ultrazohm/uz_d_voltage_3v3_5v/doc/Level_Shifter_Output_Enable_Concept.png

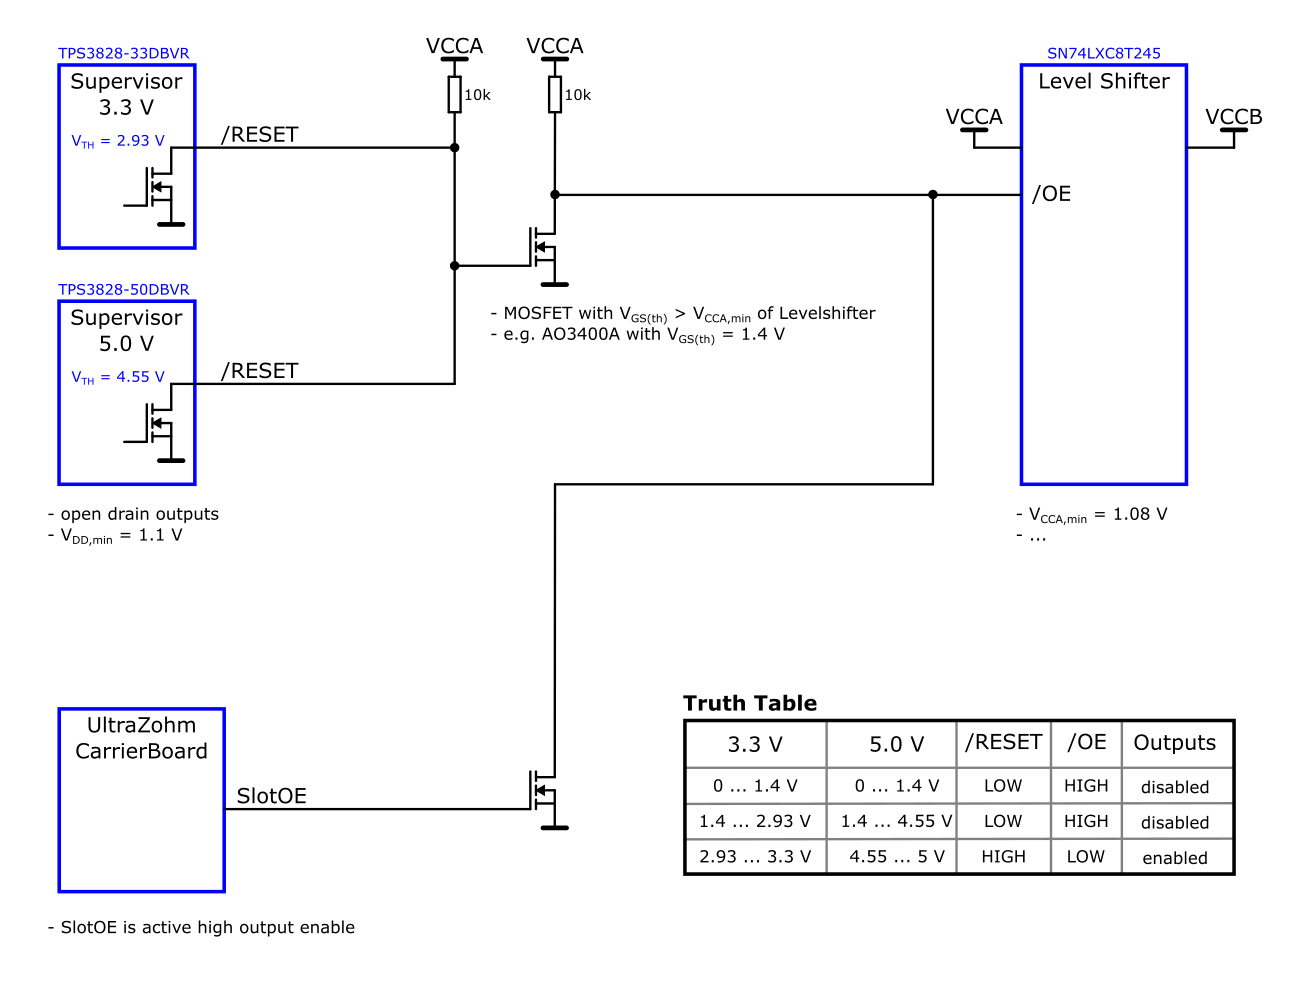
doc/Level_Shifter_Output_Enable_Concept.png
