ultrazohm/uz_d_voltage_3v3_5v/Project Outputs for UZ_D_Voltage_3V3_5V/Rev03/BOM/BOM_JLC-UZ_D_Voltage_3V3_5V(Default).xlsx

Quantity | Comment | Designator | Manufacturer | Value | Description | Footprint | Voltage | Dielectric | Manufacturer Part Number | LCSC Part Number
12 | 100 nF | C1, C2, C3, C4, C5, C6, C7, C8, C9, C10, C11, C12 | UZgen | 100 nF | Generic capacitor | C_0603_TE | 50V |  | UZgen_C_0603_100nF_50V_X7R
2 | 1 µF | C13, C15 | UZgen | 1 µF | Generic capacitor | C_0603_TE | 16V |  | UZgen_C_0603_1uF_16V_X7R
1 | 220 nF | C14 | UZgen | 220 nF | Generic capacitor | C_0603_TE | 50V |  | UZgen_C_0603_220nF_50V_X7R
1 | 150060BS84000 | D1 | Wuerth Elektronik |  | WL-SMCW SMD Mono-color Chip LED Waterclear Blue | WL-SMCW_0603 |  |  | 150060BS84000 | C5197644
1 | LED RGB | D2 | Amicc | LED RGB | RGB LED - SMD 1615 | LED_1615 |  |  | A-SP1943B1GHR6C-C01-2T | C19171342
3 | Littelfuse_PTC_1812 | F1, F2, F3 | Littelfuse | PTC, 1.1 A, 24V | POLYSWITCH RESETTABLE DEVICES | 1812_PTC_Polyfuse_Littelfuse | 24V |  | Littelfuse_PTC_1812 | C70119
1 | LPF-C011304S | LG1 | Lumex | LPF-C011304S | LED Light Pipes RA Light Pipe Clr 2.8mm Round | LPF-C011304S |  |  | LPF-C011304S
2 | BSS138LT3G | Q1, Q2 | ON Semicondutor | 50 V | Power MOSFET, n-Channel, 200 mA, 50 V | SOT-23-3 |  |  | BSS138LT3G | C83790
71 | 10k | R2, R39, R40, R41, R42, R43, R44, R45, R46, R47, R48, R49, R50, R51, R52, R53, R54, R55, R56, R57, R58, R59, R60, R61, R62, R63, R64, R65, R66, R67, R68, R69, R70, R71, R72, R73, R74, R75, R78, R79, R85, R86, R87, R88, R89, R90, R91, R92, R93, R94, R95, R96, R97, R98, R99, R100, R101, R102, R103, R104, R105, R106, R107, R108, R109, R110, R111, R112, R113, R114, R115 | UZgen | 10k | Generic resistor | R_0603_TE |  |  | UZgen_R_0603_10k
3 | 4k7 | R3, R4, R5 | UZgen | 4k7 | Generic resistor | R_0603_TE |  |  | UZgen_R_0603_4k7
2 | 100k | R6, R7 | UZgen | 100k | Generic resistor | R_0603_TE |  |  | UZgen_R_0603_100k
1 | 24k9 | R8 | Vishay | 24k9 | SMD resistor 1% | RES 0603_1608 |  |  | CRCW060324K9FKEA | C844763
30 | 39R | R9, R10, R11, R12, R13, R14, R15, R16, R17, R18, R19, R20, R21, R22, R23, R24, R25, R26, R27, R28, R29, R30, R31, R32, R33, R34, R35, R36, R37, R38 | UZgen | 39R | Generic resistor | R_0603_TE |  |  | UZgen_R_0603_39R
2 | 0R | R76, R77 | UZgen | 0R | Generic resistor | R_0603_TE |  |  | UZgen_R_0603_0R
1 | 2k7 | R80 | UZgen | 2k7 | Generic resistor | R_0603_TE |  |  | UZgen_R_0603_2k7
1 | 1k | R81 | UZgen | 1k | Generic resistor | R_0603_TE |  |  | UZgen_R_0603_1k
2 | 300R | R82, R83 | UZgen | 300R | Generic resistor | R_0603_TE |  |  | UZgen_R_0603_300R
1 | 47R | R84 | UZgen | 47R | Generic resistor | R_0603_TE |  |  | UZgen_R_0603_47R
1 | SS-3235S-L1 | S1 | XKB Connection | DPDT | 50mA Horizontal attachment DPDT 12V 12V 50mA 10,000 times Black SMD Slide Switches ROHS | SS-3235S-L1 |  |  | SS-3235S-L1 | C500055
1 | CAS-120B1 | S2 | Nidec Components | SPDT | Slide Switches SPDT, ON-ON, slide, gull wing SMD terminals, 100mA @ 6V DC, bulk packaging, non-washable without seal tape | CAS120B1 |  |  | CAS-120B1 | C3664598
1 | DSHP04TS-S | SW1 | XKB Connectivity | DIP-Switch | 04p, 1.27mm Pitch, Horizontal, HP Type, SMT, flat Actuator, black, with Tape, T&R | 416131160804 |  |  | DSHP04TS-S | C319050
9 | 5015 | TP3, TP4, TP7, TP8, TP9, TP10, TP11, TP12, TP13 | Keystone Electronics | SMD Testpoint | Circuit Board Hardware - PCB SM TEST POINT ON T&R - MINIATURE | FP-5015-MFG |  |  | 5015 | C5199798
1 | M24C02-WMN6TP | U1 | STMicroelectronics | M24C02-WMN6TP | 2Kbit I2C SOP-8 EEPROM ROHS | D0008A_N |  |  | M24C02-WMN6TP | C7562
4 | SN74LXC8T245PWR | U2, U3, U4, U5 | Texas Instruments | 1.1 - 5.5 V | 8-bit Dual-Supply Bus Transceiver with Configurable Level Shifting and 3-State Outputs | TSSOP-24 |  |  | SN74LXC8T245PWR | C4363995
1 | TLV840MADL29DBVR | U6 | Texas Instruments | TLV840-29 | Supervisory Circuits 2.9V Monitor | SOT23-5_DBV |  |  | TLV840MADL29DBVR | C3687807
1 | PCA9534PWR | U7 | Texas Instruments |  | 8-bit 2.3- to 5.5-V I2C/SMBus I/O expander with interrupt & config registers | TSSOP-16_PW0016A_N |  |  | PCA9534PWR | C133803
1 | TLV840NADL46DBVR | U8 | Texas Instruments | TLV840-46 | Supervisory Circuits 4.6V Monitor | SOT23-5_DBV |  |  | TLV840NADL46DBVR | C2870132
1 | IPL1-115-01-L-D-RA-K | X2 | SAMTEC |  | Terminal Assembly, Double Row, Right Angle, Thru-Hole, 2.54 mm x 2.54 mm Pitch, 30 Pins | IPL1-115-01-XX-D-RA |  |  | IPL1-115-01-L-D-RA-K
1 | IPL1-120-01-L-D-RA-K | X3 | SAMTEC |  | Terminal Assembly, Double Row, Right Angle, Thru-Hole, 2.54 mm x 2.54 mm Pitch, 40 Pins | IPL1-120-01-XX-D-RA |  |  | IPL1-120-01-L-D-RA-K
