ultrazohm/uz_d_voltage_3v3_5v/Project Outputs for UZ_D_Voltage_3V3_5V/Rev03/DOC/SCH_UZ_D_Voltage_3V3_5V_Default_Rev03.PDF

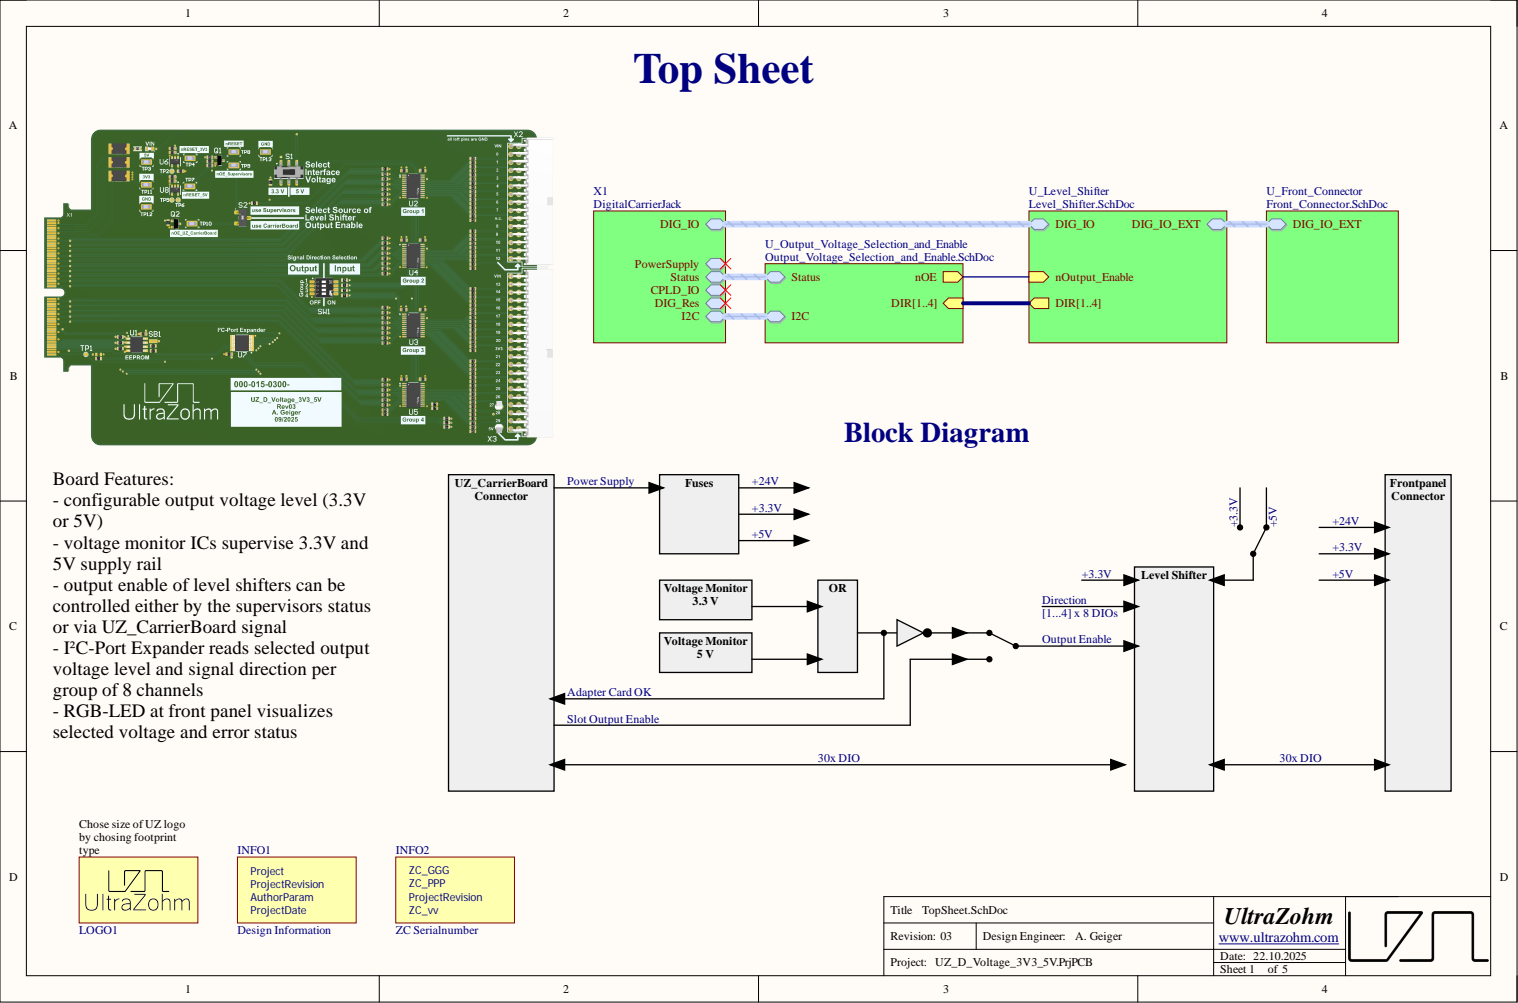
[picture p4: page 1]

Board Features:
- configurable output voltage level (3.3V
- voltage monitor ICs supervise 3.3V and
5V supply rail
- output enable of level shifters can be
controlled either by the supervisors status
or via UZ_CarrierBoard signal
- I²C-Port Expander reads selected output
voltage level and signal direction per
group of 8 channels
- RGB-LED at front panel visualizes
selected voltage and error status

Chose size of UZ logo
by chosing footprint
type

Revision:

Date: 22.10.2025

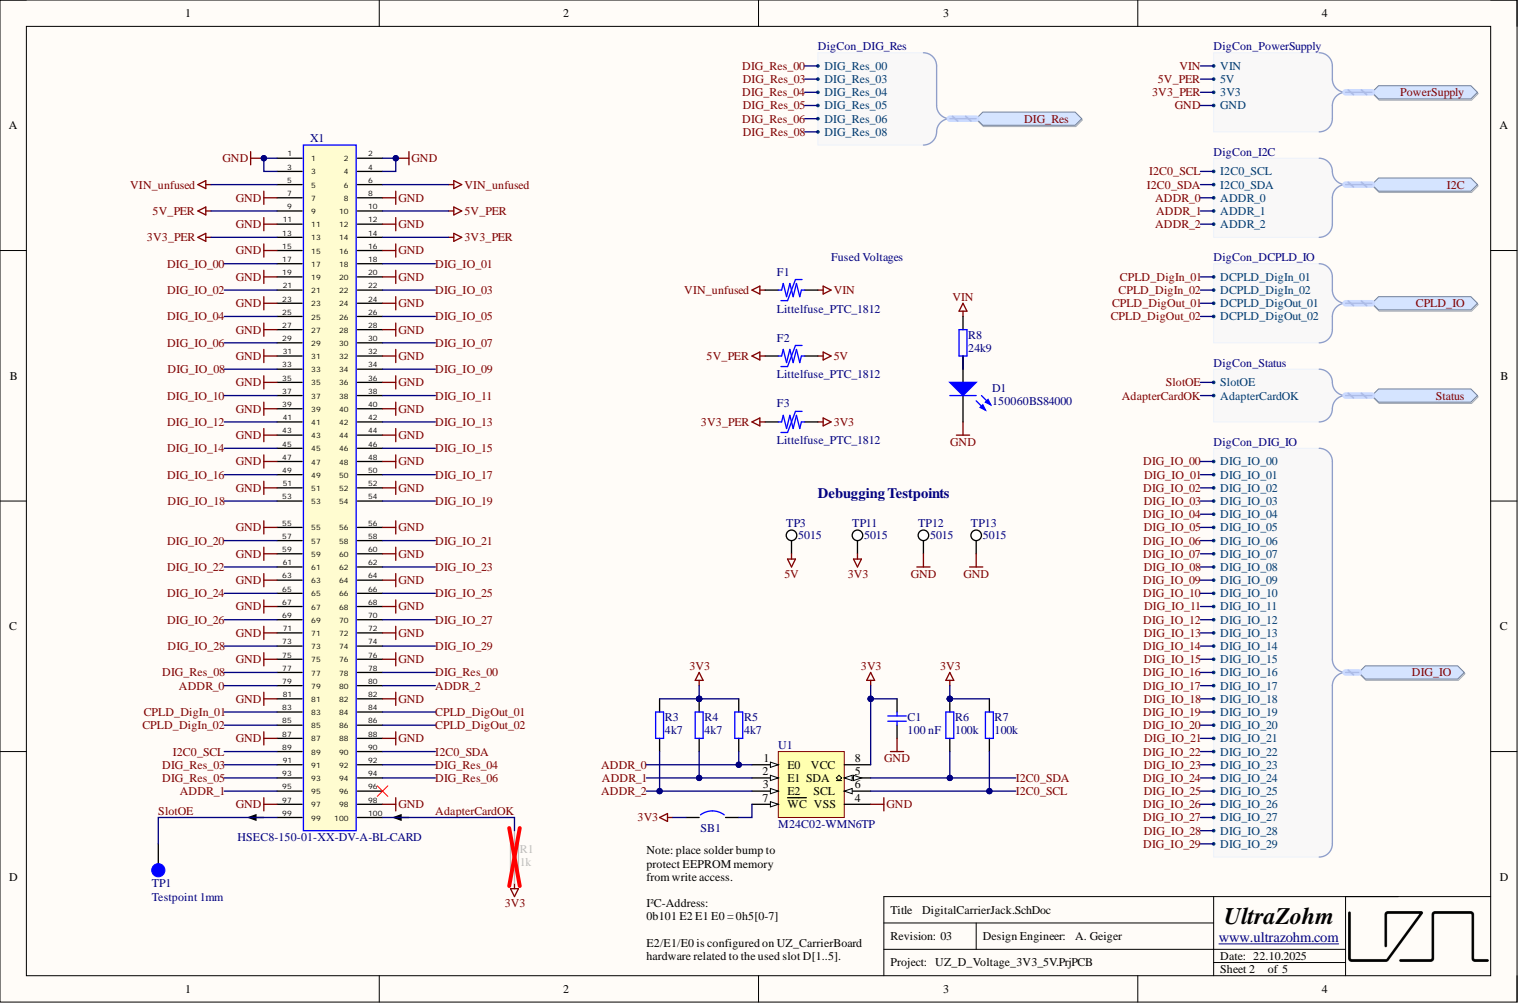
[picture p5: page 2]

Rev i s n | Des g E er A. Gei ger

Dat e :

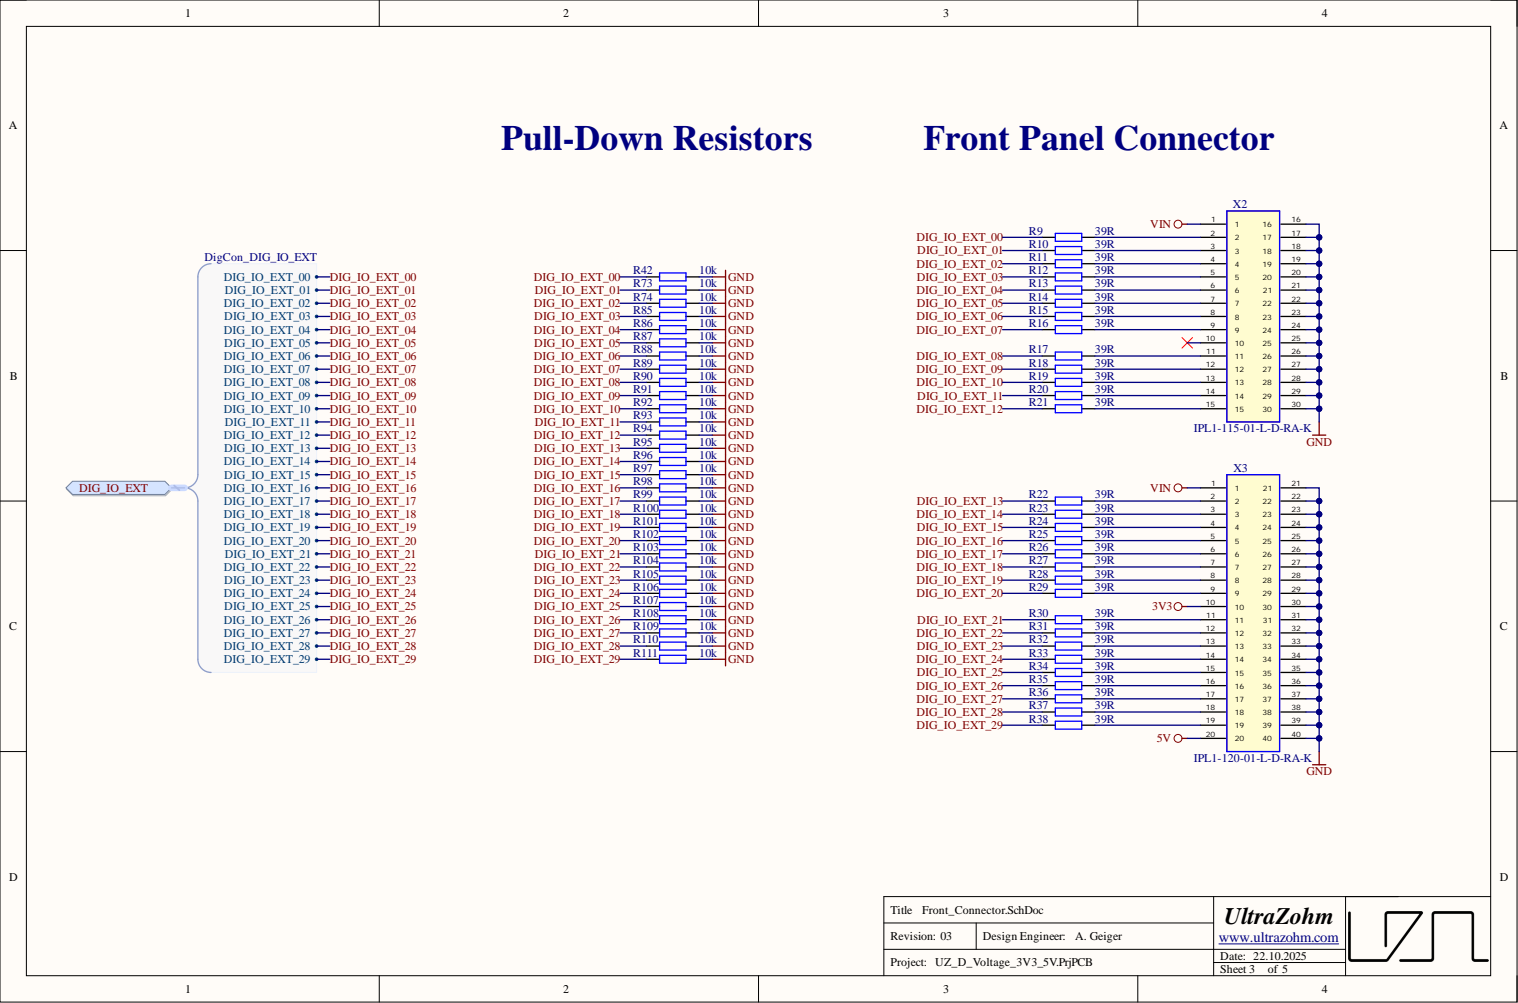
[picture p6: page 3]

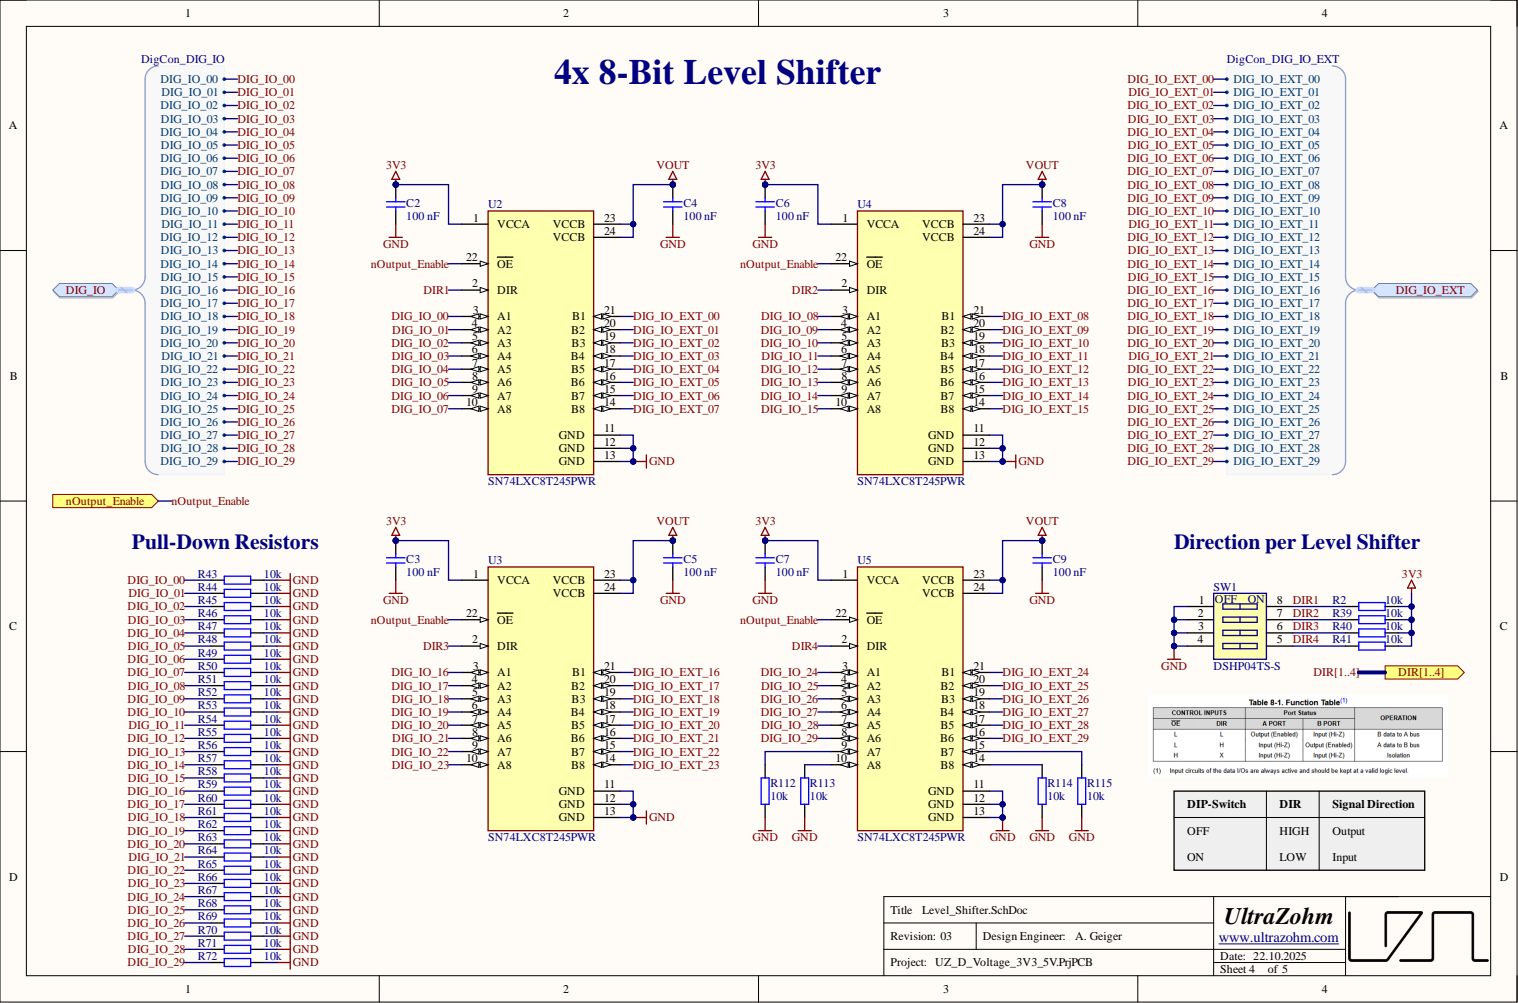
[picture p7: page 4]

Direction per Level Shifter

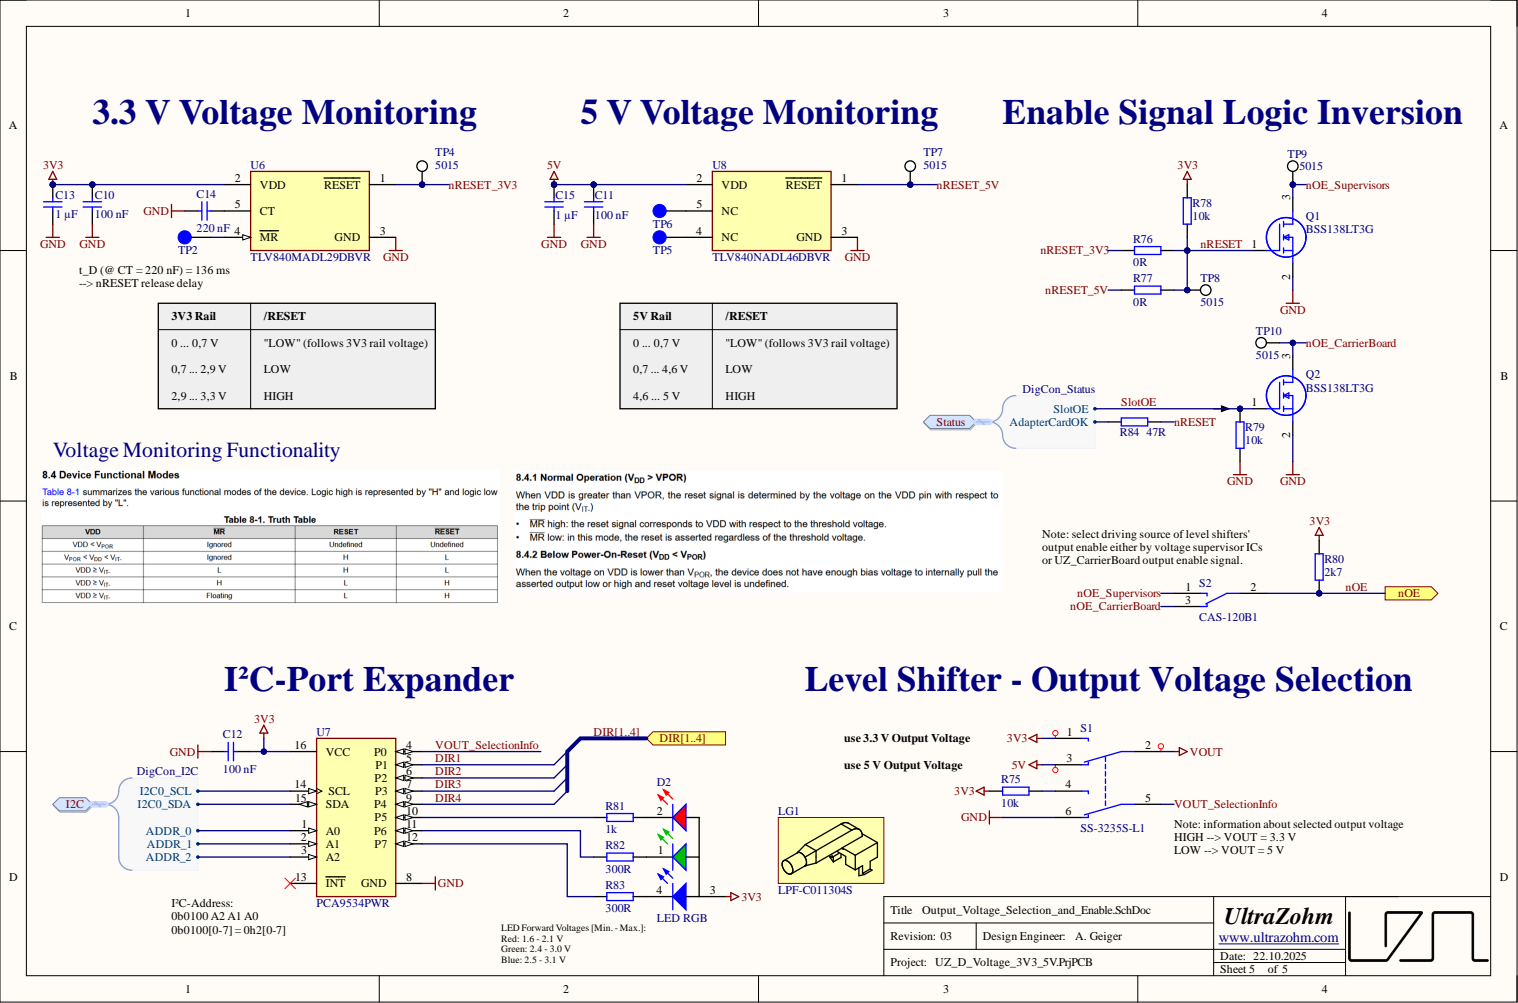
[picture p8: page 5]

Enable Signal Logic Inversion

"LOW" (follows 3V3 rail voltage)

Note: select driving source of level shifters'
output enable either by voltage supervisor ICs
or UZ_CarrierBoard output enable signal.

Level Shifter - Output Voltage Selection

VOUT_SelectionInfo
Note: information about selected output voltage
HIGH --> VOUT = 3.3 V
LOW --> VOUT = 5 V

LED Forward Voltages [Min. - Max.]:
Red: 1.6 - 2.1 V
Green: 2.4 - 3.0 V
Blue: 2.5 - 3.1 V

Revision:

Date: 22.10.2025
