ultrazohm/uz_d_voltage_3v3_5v/Project Outputs for UZ_D_Voltage_3V3_5V/Rev03/DOC/ASM_UZ_D_Voltage_3V3_5V_Default_03.PDF

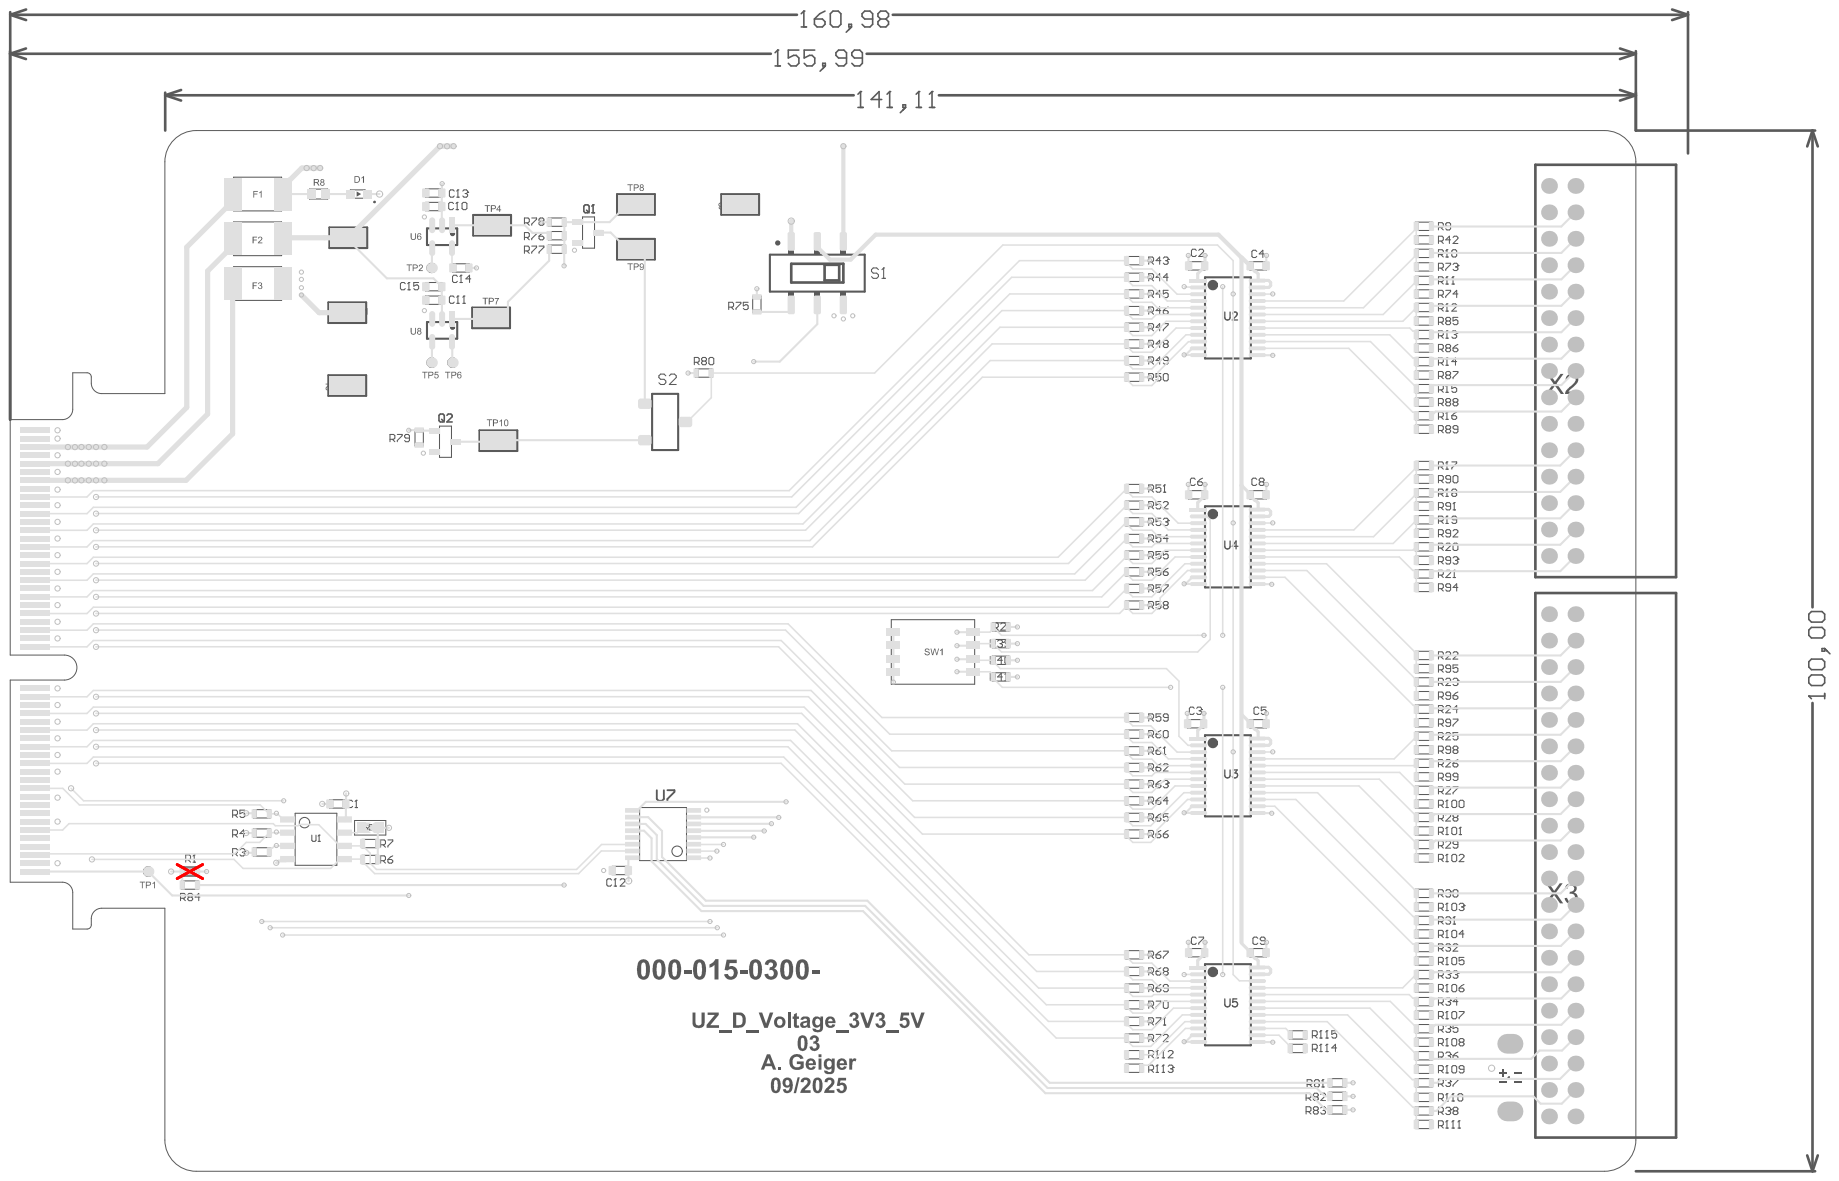
[picture p14: page 1]

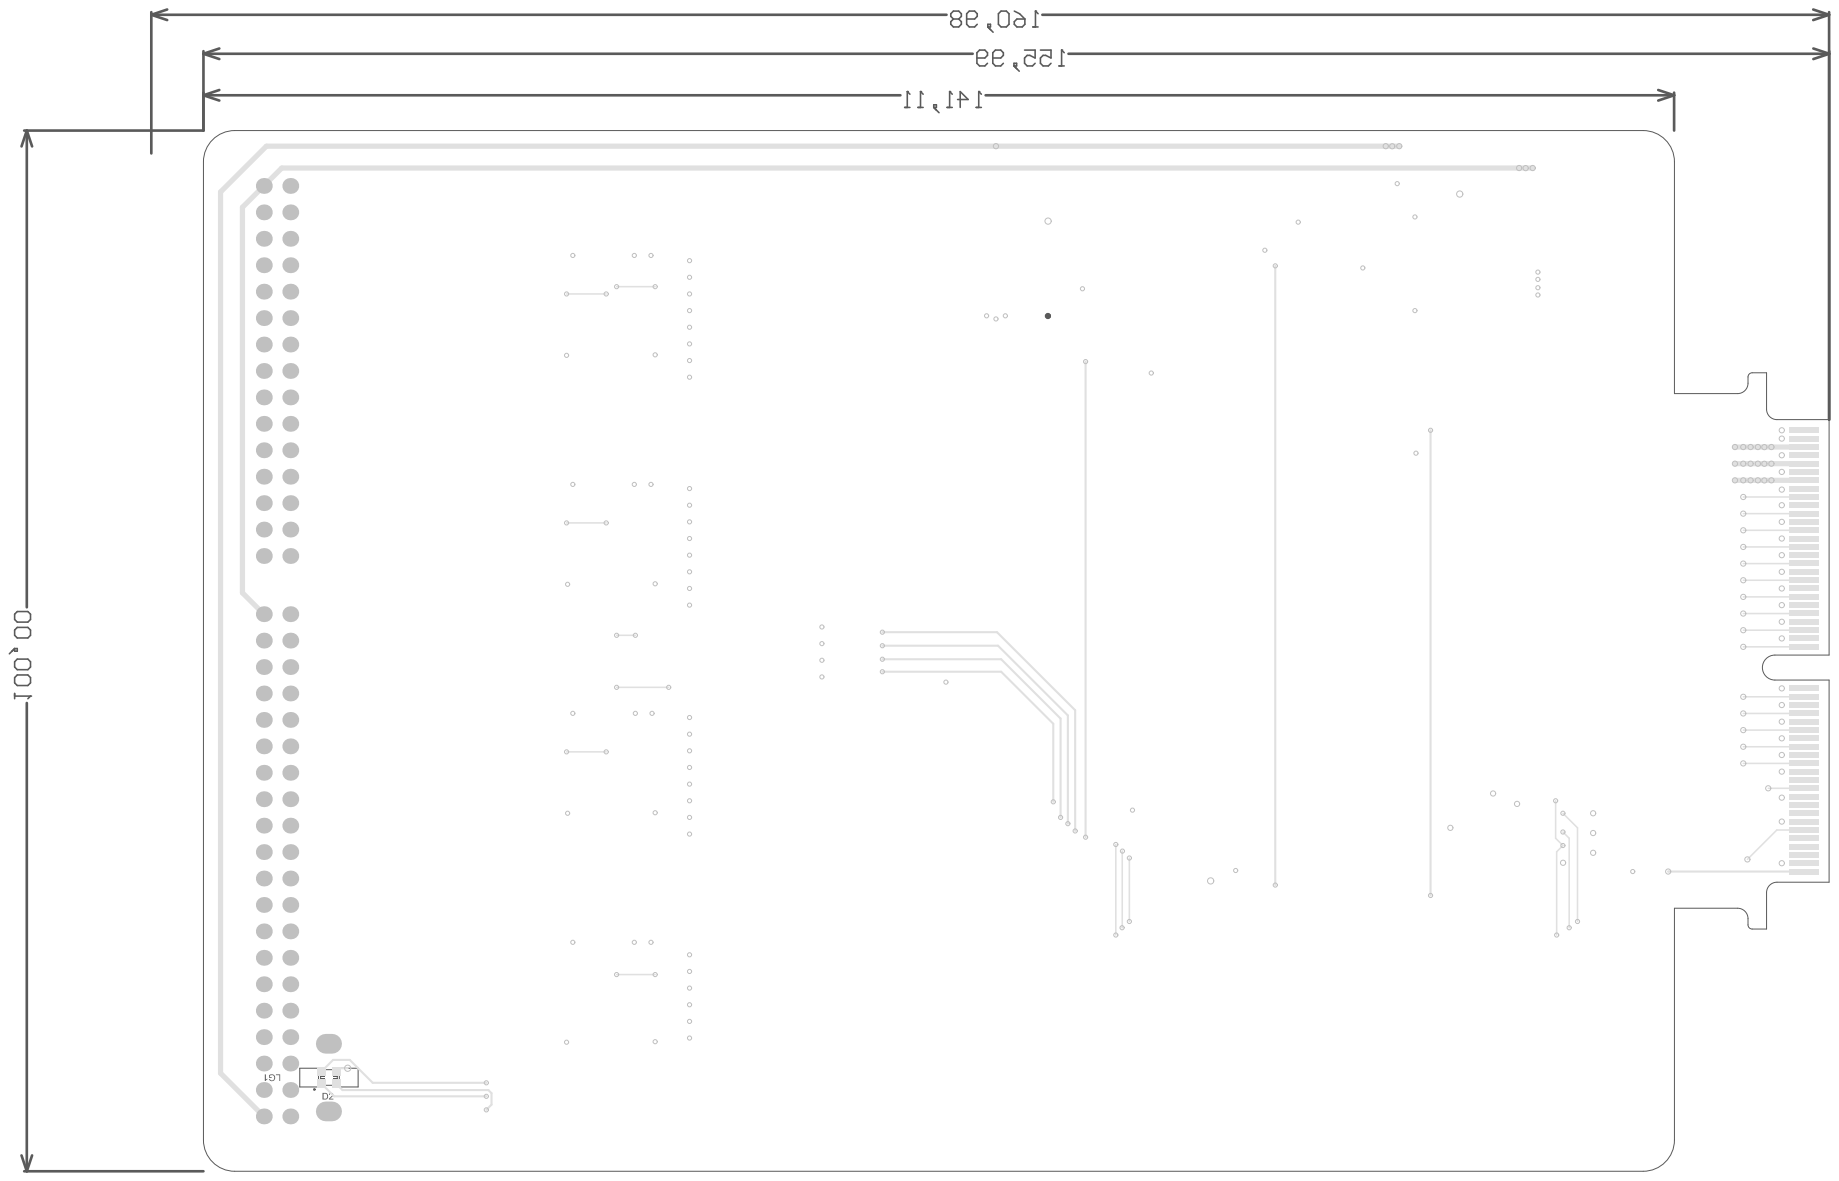
[picture p15: page 2]
