ultrazohm/uz_d_voltage_3v3_5v/Project Outputs for UZ_D_Voltage_3V3_5V/Rev03/100k_pulldown/DOC/3D_View_Bot.PDF

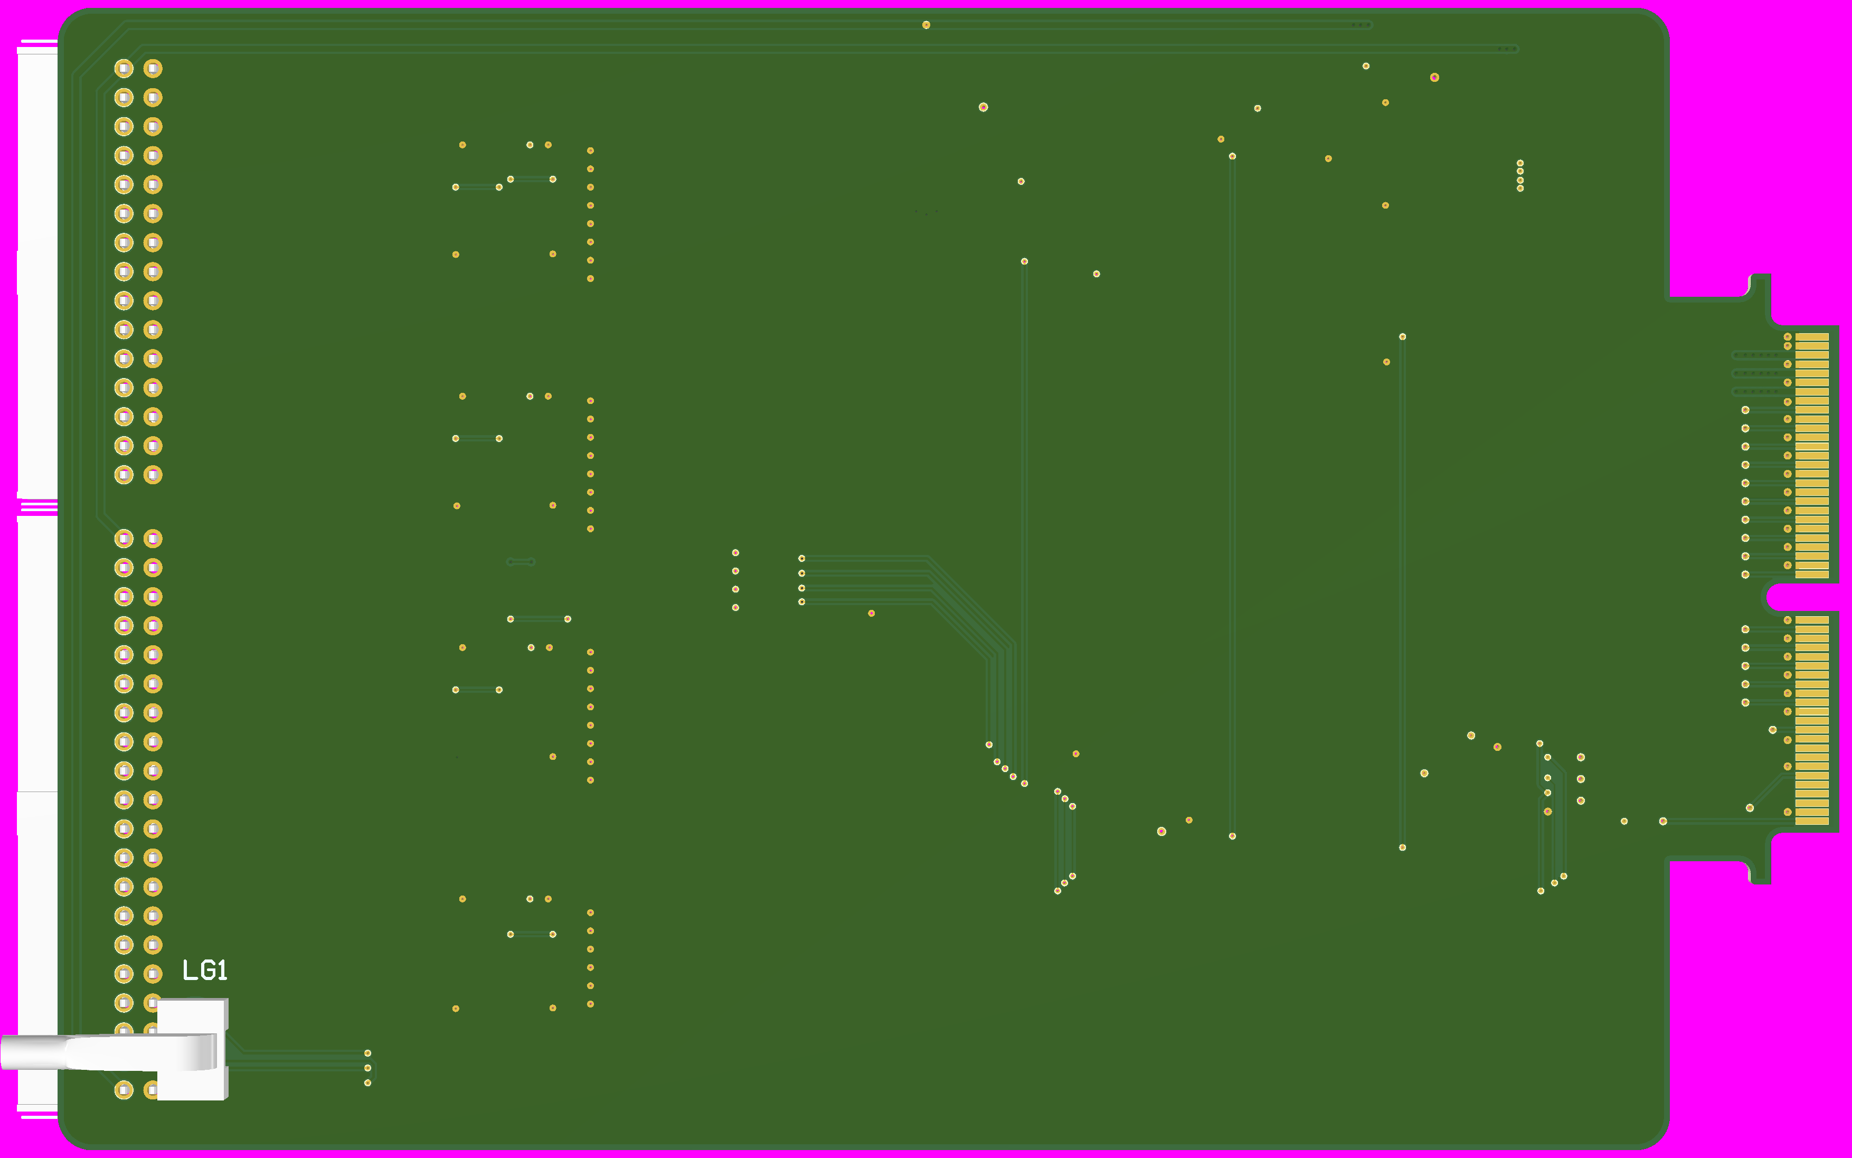
[picture p17: page 1]
