ultrazohm/uz_d_voltage_3v3_5v/Project Outputs for UZ_D_Voltage_3V3_5V/Rev03/100k_pulldown/DOC/ASM_UZ_D_Voltage_3V3_5V_100k_pulldown_IOs_03.PDF

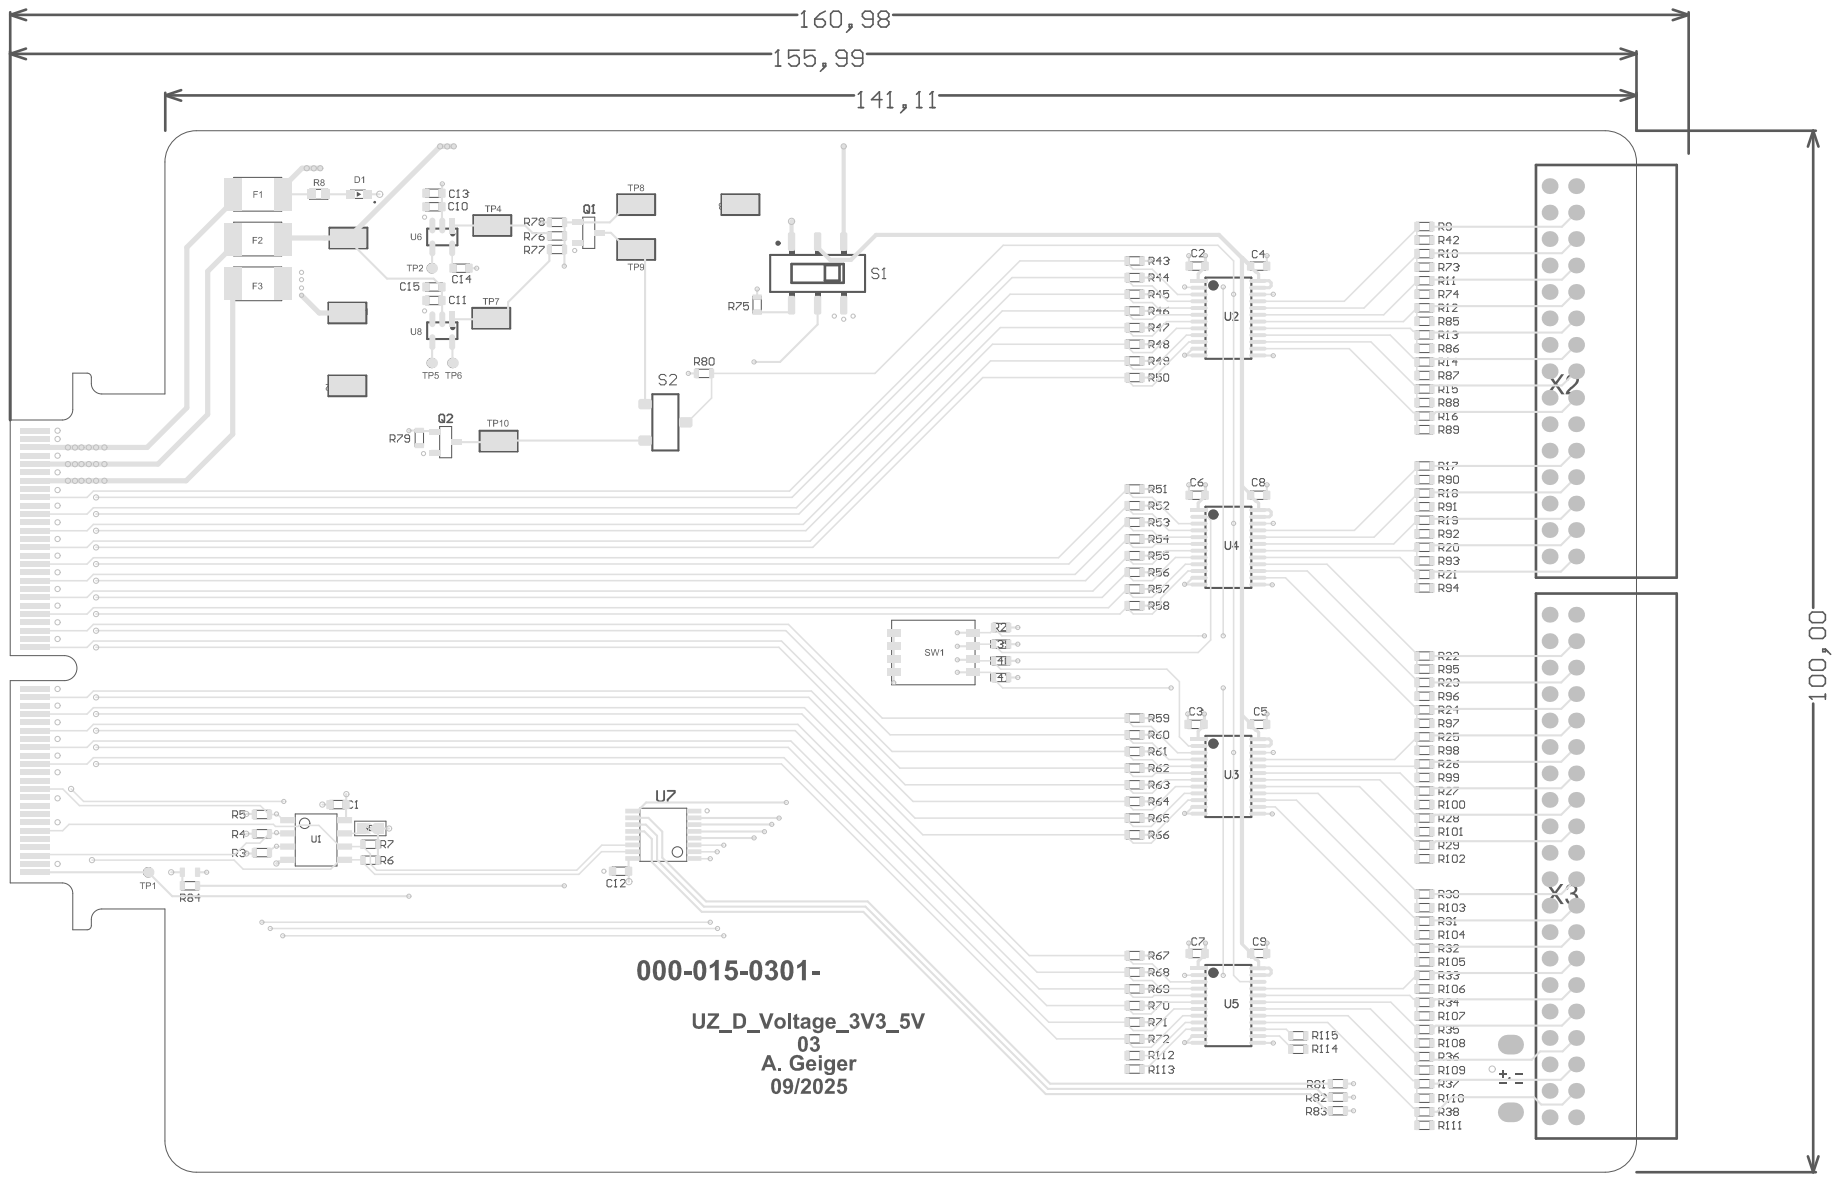
[picture p19: page 1]

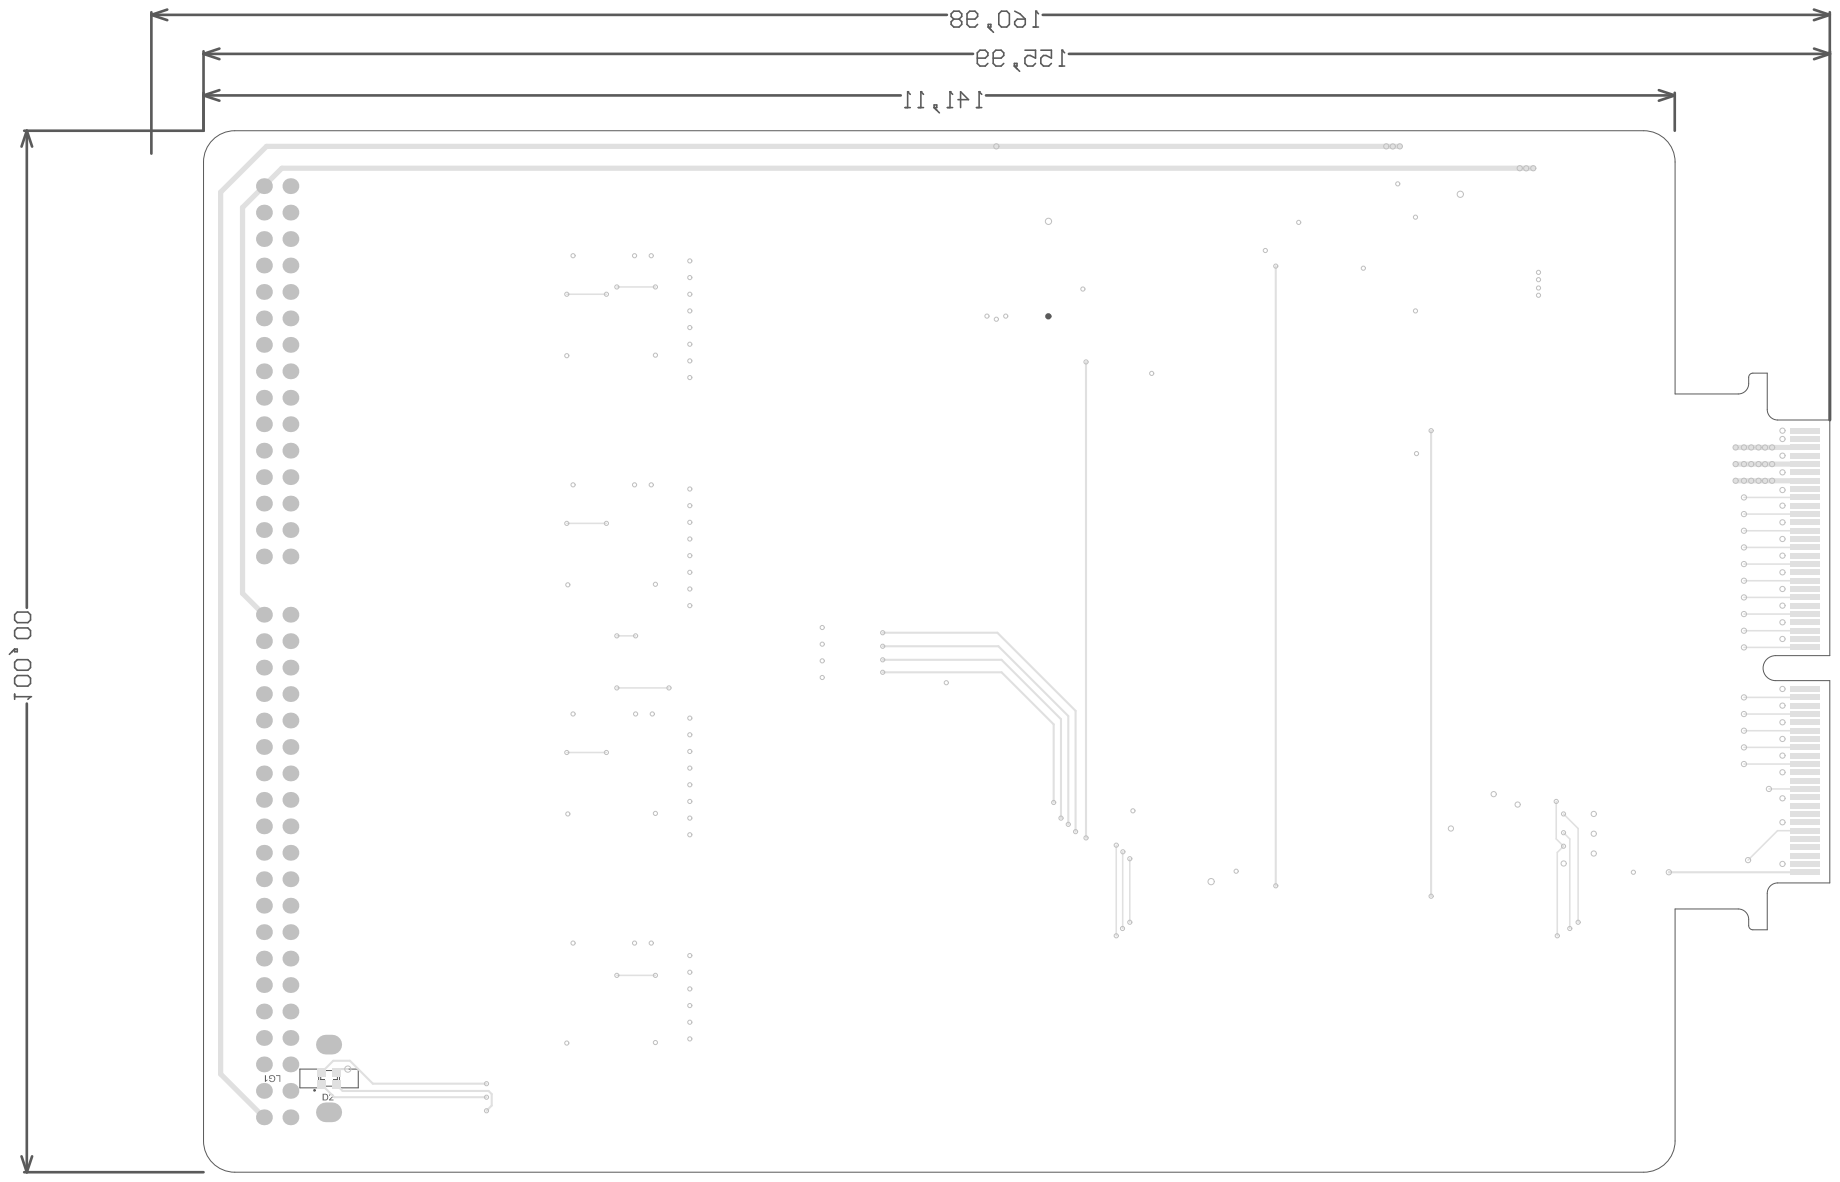
[picture p20: page 2]
