ultrazohm/uz_d_voltage_3v3_5v/Project Outputs for UZ_D_Voltage_3V3_5V/Rev02/ASM_UZ_D_Voltage_3V3_5V_Default_Rev02.PDF

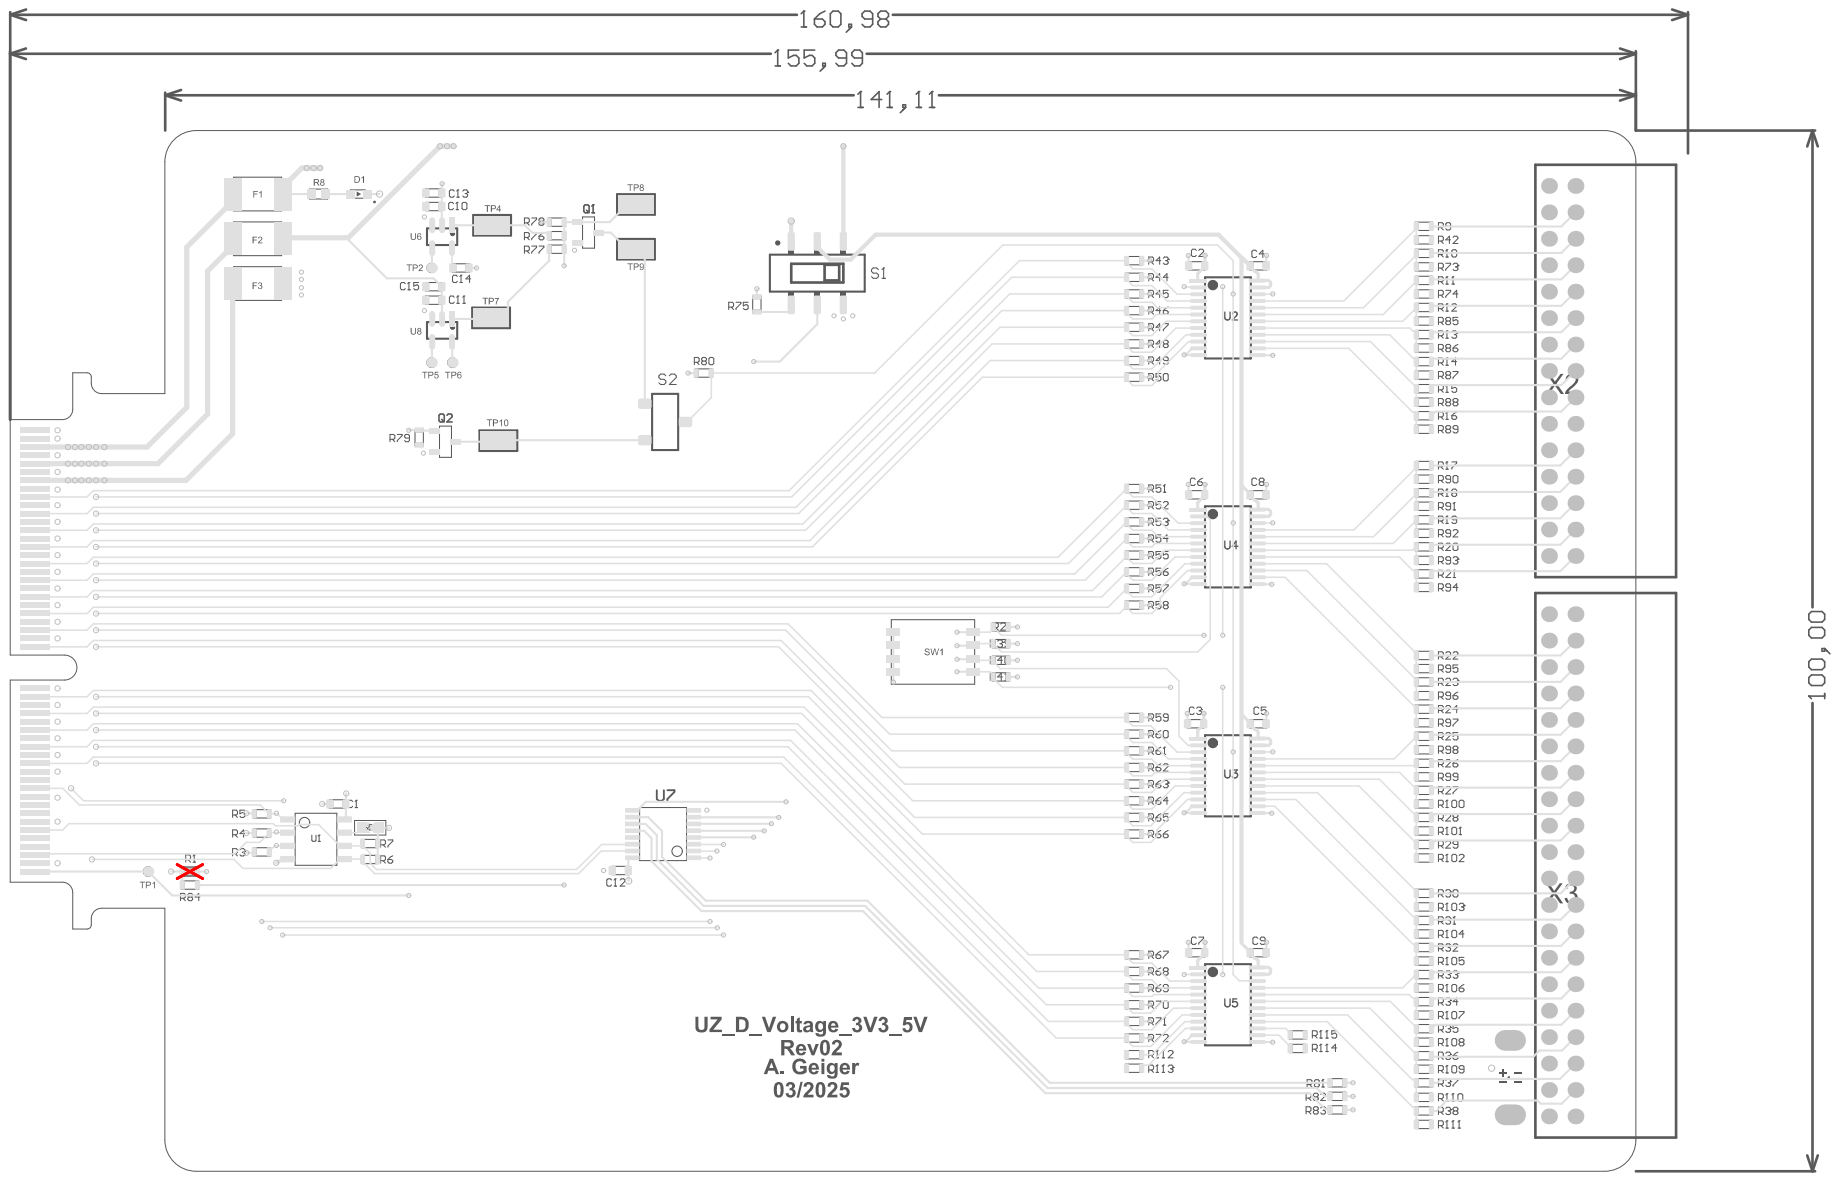
[picture p26: page 1]

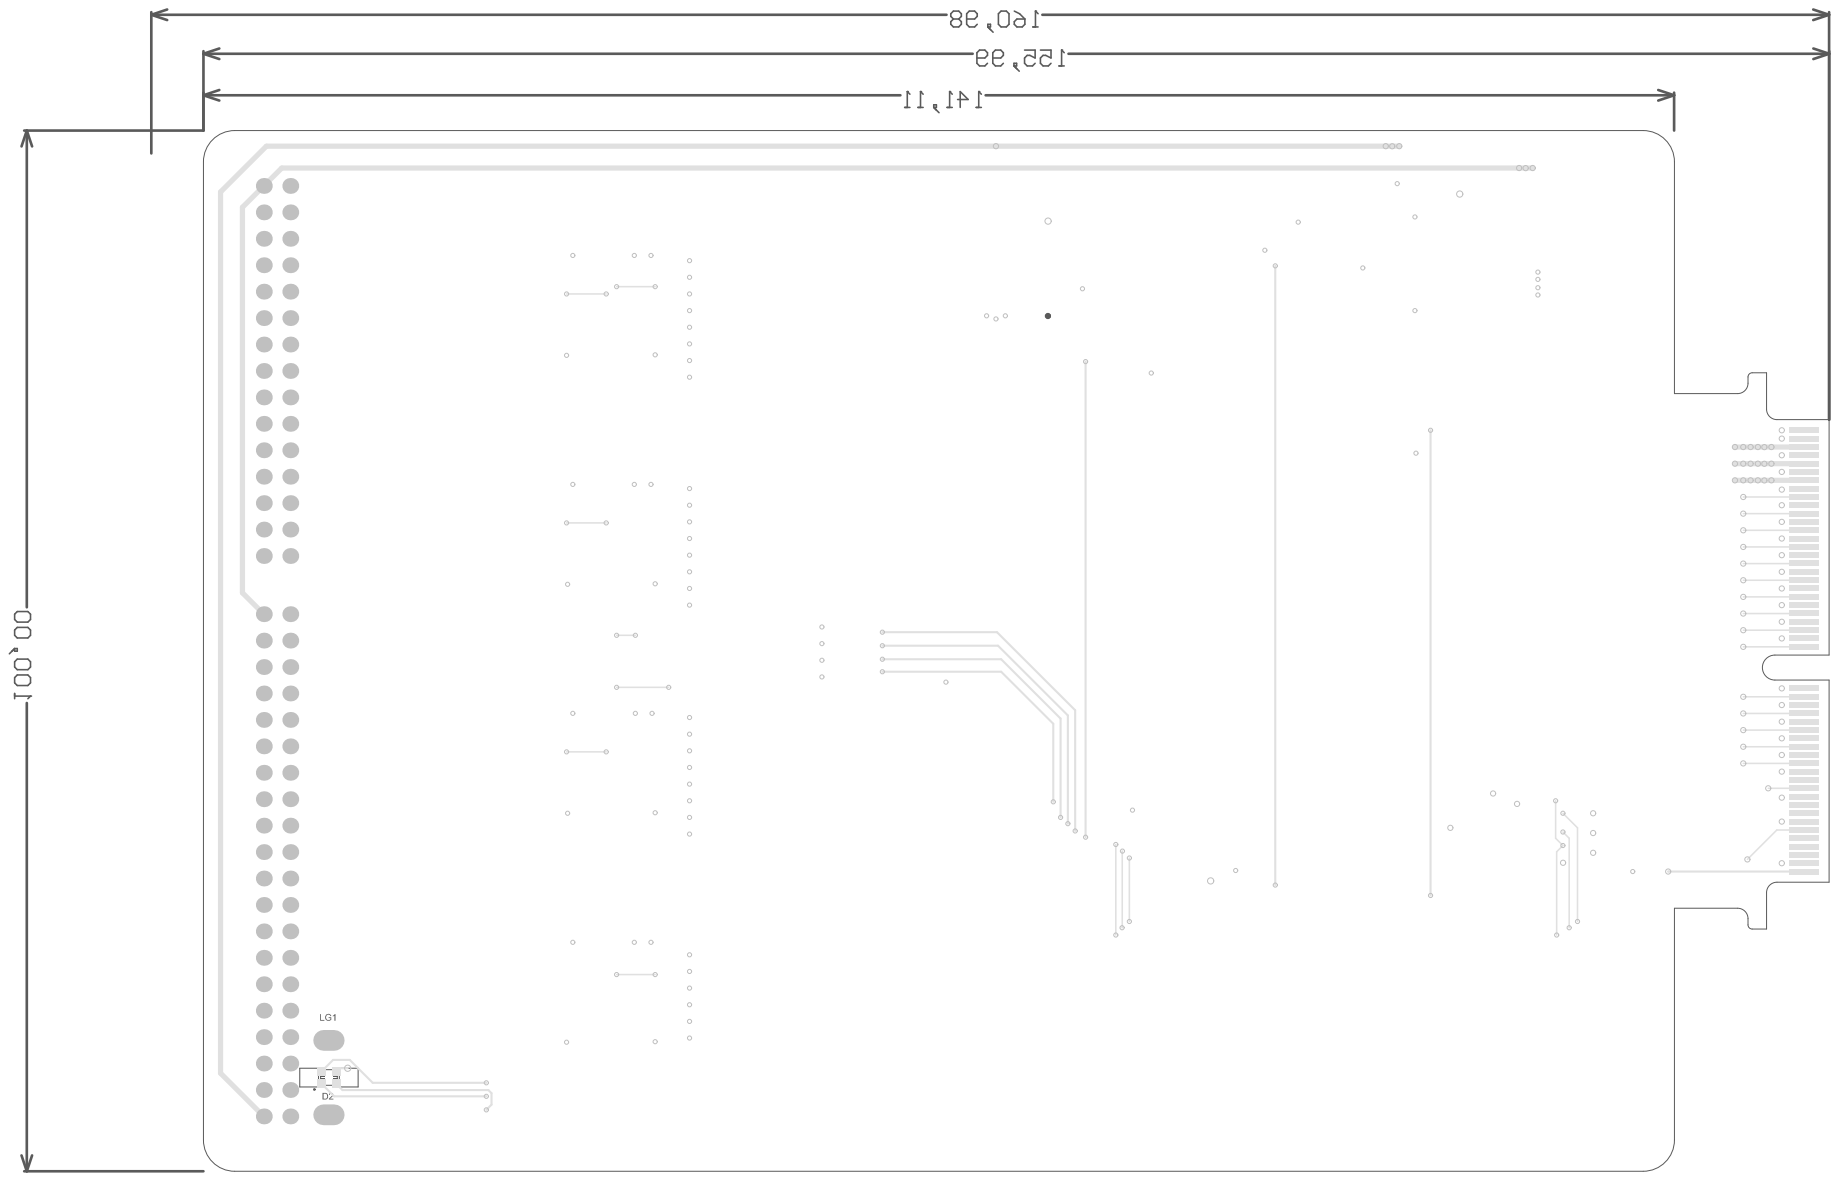
[picture p27: page 2]
