ultrazohm/uz_d_voltage_3v3_5v/(list of files, drawings)

Other design files:
DigitalCarrierJack.SchDoc
Front_Connector.SchDoc
Level_Shifter.SchDoc
Output_Voltage_Selection_and_Enable.SchDoc
TopSheet.SchDoc
UZ_D_Voltage_3V3_5V.PcbDoc
UZ_D_Voltage_3V3_5V.PrjPCB
