ultrazohm/uz_d_voltage_3v3_5v/(commit log)

2024-12-16 copy project from UZ_D_Voltage_3V3; add level shifter; add voltage monitor chips
    [DigitalCarrierJack.SchDoc, Front_Connector.SchDoc, Level_Shifter.SchDoc, TopSheet.SchDoc, UZ_D_Voltage_3V3_5V.PcbDoc, UZ_D_Voltage_3V3_5V.PrjPCB]
2024-12-16 connect signals
    [Level_Shifter.SchDoc, Output_Voltage_Selection_and_Enable.SchDoc, TopSheet.SchDoc, UZ_D_Voltage_3V3_5V.PrjPCB]
2024-12-17 insert switch to choose output voltage
    [DigitalCarrierJack.SchDoc, Front_Connector.SchDoc, Level_Shifter.SchDoc, Output_Voltage_Selection_and_Enable.SchDoc, TopSheet.SchDoc, UZ_D_Voltage_3V3_5V.PrjPCB]
2024-12-17 add block diagram
    [DigitalCarrierJack.SchDoc, Front_Connector.SchDoc, Level_Shifter.SchDoc, Output_Voltage_Selection_and_Enable.SchDoc, TopSheet.SchDoc, UZ_D_Voltage_3V3_5V.PrjPCB]
2024-12-20 insert pull-down resistors at CPLD side
    [Level_Shifter.SchDoc, TopSheet.SchDoc, UZ_D_Voltage_3V3_5V.PrjPCB]
2024-12-20 routing of level shifter
    [DigitalCarrierJack.SchDoc, Level_Shifter.SchDoc, Output_Voltage_Selection_and_Enable.SchDoc, UZ_D_Voltage_3V3_5V.PcbDoc, UZ_D_Voltage_3V3_5V.PrjPCB]
2024-12-20 add testpoints
    [Output_Voltage_Selection_and_Enable.SchDoc, UZ_D_Voltage_3V3_5V.PcbDoc]
2024-12-20 voltage monitor placing
    [UZ_D_Voltage_3V3_5V.PcbDoc]
2024-12-20 routing around level shifters
    [UZ_D_Voltage_3V3_5V.PcbDoc]
2024-12-20 finish routing
    [DigitalCarrierJack.SchDoc, UZ_D_Voltage_3V3_5V.PcbDoc, UZ_D_Voltage_3V3_5V.PrjPCB]
2024-12-20 insert useful Top Overlay descriptions
    [Level_Shifter.SchDoc, UZ_D_Voltage_3V3_5V.PcbDoc, UZ_D_Voltage_3V3_5V.PrjPCB]
2024-12-22 add connection to enable level shifter outputs by CarrierReady Signal
    [Level_Shifter.SchDoc, Output_Voltage_Selection_and_Enable.SchDoc, TopSheet.SchDoc, UZ_D_Voltage_3V3_5V.PrjPCB]
2024-12-22 change switch from Dual SPDT to DPDT
    [DigitalCarrierJack.SchDoc, Output_Voltage_Selection_and_Enable.SchDoc, UZ_D_Voltage_3V3_5V.PcbDoc, UZ_D_Voltage_3V3_5V.PrjPCB]
2024-12-22 change pull-down resistors (to avoid CPLD glitches) from 1k to 5k1 to reduce steady state current consumption
    [Level_Shifter.SchDoc, UZ_D_Voltage_3V3_5V.PcbDoc, UZ_D_Voltage_3V3_5V.PrjPCB]
2025-01-24 change level-shifter nOE from voltage monitor pin nRESET to RESET
    [Output_Voltage_Selection_and_Enable.SchDoc, UZ_D_Voltage_3V3_5V.PrjPCB]
2025-01-24 change pull-down resistors from 5k1 to 10k
    [Level_Shifter.SchDoc]
2025-01-24 update layout to schematic changes
    [UZ_D_Voltage_3V3_5V.PrjPCB]
2025-03-21 - change TPS3825 (3.3V and 5.0V) to TPS3828 - add MOSFETs to invert /RESET signal - add DIP switch to disable /OE from supervisor ICs or UZ_CarrierBoard - add I2C-Port Expander to read selected outpu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
    [DigitalCarrierJack.SchDoc, Output_Voltage_Selection_and_Enable.SchDoc, TopSheet.SchDoc, UZ_D_Voltage_3V3_5V.PrjPCB]
2025-03-21 - connect level shifter direction to port expander - add RGB LED to port expander
    [DigitalCarrierJack.SchDoc, Level_Shifter.SchDoc, Output_Voltage_Selection_and_Enable.SchDoc, TopSheet.SchDoc, UZ_D_Voltage_3V3_5V.PrjPCB]
2025-03-22 add light guard for RGB LED
    [Output_Voltage_Selection_and_Enable.SchDoc]
2025-03-27 - change voltage supervisors to TLV840 - connect /RESET signal to UZ_CarrierBoard connector signal "AdapterCardOK" - add SPDT switch to change /OE-Signal source of level shifter between supervisors o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
    [Output_Voltage_Selection_and_Enable.SchDoc]
2025-03-28 - extend PCB from 2-layer to 4-layer - add some testpoints - part placement in PCB
    [DigitalCarrierJack.SchDoc, Output_Voltage_Selection_and_Enable.SchDoc, UZ_D_Voltage_3V3_5V.PrjPCB]
2025-03-28 - update block diagram - generate schematic / assembly drawing / BOM
    [BOM_JLC-UZ_D_Voltage_3V3_5V(Default).xlsx, DigitalCarrierJack.SchDoc, Output_Voltage_Selection_and_Enable.SchDoc, TopSheet.SchDoc, UZ_D_Voltage_3V3_5V.PrjPCB]
2025-04-01 - modify block diagram - add CT capacitor at 3.3V supervisor to increase delay time - remove Collective Fault signal from status bus harness
    [DigitalCarrierJack.SchDoc, Output_Voltage_Selection_and_Enable.SchDoc, TopSheet.SchDoc]
2025-04-01 - add 1uF caps to supervisors VDD inputs - change I²C-Port Expander address to defined by carrier board's pull-up and pull-downs
    [DigitalCarrierJack.SchDoc, Output_Voltage_Selection_and_Enable.SchDoc]
2025-04-01 pull-down resistors at secondary side (VCCB) added (but DNP as default assembly variant)
    [Front_Connector.SchDoc, UZ_D_Voltage_3V3_5V.PrjPCB]
2025-04-01 BOM, schematic and assembly drawing generated
    [BOM_JLC-UZ_D_Voltage_3V3_5V(Default).xlsx]
2025-04-03 - pull-down resistors at n.c. ports of fourth level shifter - set all pull-downs at VCCB side from DNP to pollute
    [BOM_JLC-UZ_D_Voltage_3V3_5V(Default).xlsx, Level_Shifter.SchDoc, UZ_D_Voltage_3V3_5V.PrjPCB]
2025-04-03 production files Rev01
    [BOM_JLC-UZ_D_Voltage_3V3_5V(Default)__23Dec2024mod.xlsx, Pick Place for UZ_D_Voltage_3V3_5V(Default).csv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]
2025-06-24 change ZC product number library
    [TopSheet.SchDoc, UZ_D_Voltage_3V3_5V.PrjPCB]
2025-06-24 reduce nOE Pull-Up resistor from 10k to 2k7 to avoid shark fin at 3V3 voltage rail ramp-up
    [Output_Voltage_Selection_and_Enable.SchDoc, UZ_D_Voltage_3V3_5V.PrjPCB]
2025-06-24 update light guard from library with closer holes
    [Output_Voltage_Selection_and_Enable.SchDoc, UZ_D_Voltage_3V3_5V.PrjPCB]
2025-09-05 production files Rev02 from 03April2025
    [PickPlace_UZ_D_Voltage_3V3_5V_Rev02.csv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]
2025-09-05 production files Rev03 05Sept2025
    [BOM_JLC-UZ_D_Voltage_3V3_5V(Default).xlsx, Pick Place for UZ_D_Voltage_3V3_5V(Default).csv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]
2025-09-10 correct traces that collided with lightguard
2025-10-22 add 3D picture to top sheet; generate SCH and ASM
    [Output_Voltage_Selection_and_Enable.SchDoc, TopSheet.SchDoc]
2025-11-20 outputjob for 100k pulldown
    [BOM_JLC-UZ_D_Voltage_3V3_5V(100k_pulldown_IOs).xlsx, PickPlace_UZ_D_Voltage_3V3_5V_03.csv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]
2025-11-20 adds 100k pulldown Variant
    [UZ_D_Voltage_3V3_5V.PrjPCB]
2025-11-21 add output files for 100k variant
    [BOM_JLC-UZ_D_Voltage_3V3_5V(100k_pulldown_IOs).xlsx, Pick Place for UZ_D_Voltage_3V3_5V(100k_pulldown_IOs).csv, PickPlace_UZ_D_Voltage_3V3_5V_03.csv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]
2025-11-21 add allow variation for fabrication output to variants
    [UZ_D_Voltage_3V3_5V.PrjPCB]
2025-11-24 update zip output with missing nc drill files
